jhbenevides02-dev/CPS-FINAL-PROJECT/BUILD/FINAL/AESTHETIC DESIGN/catrina.png

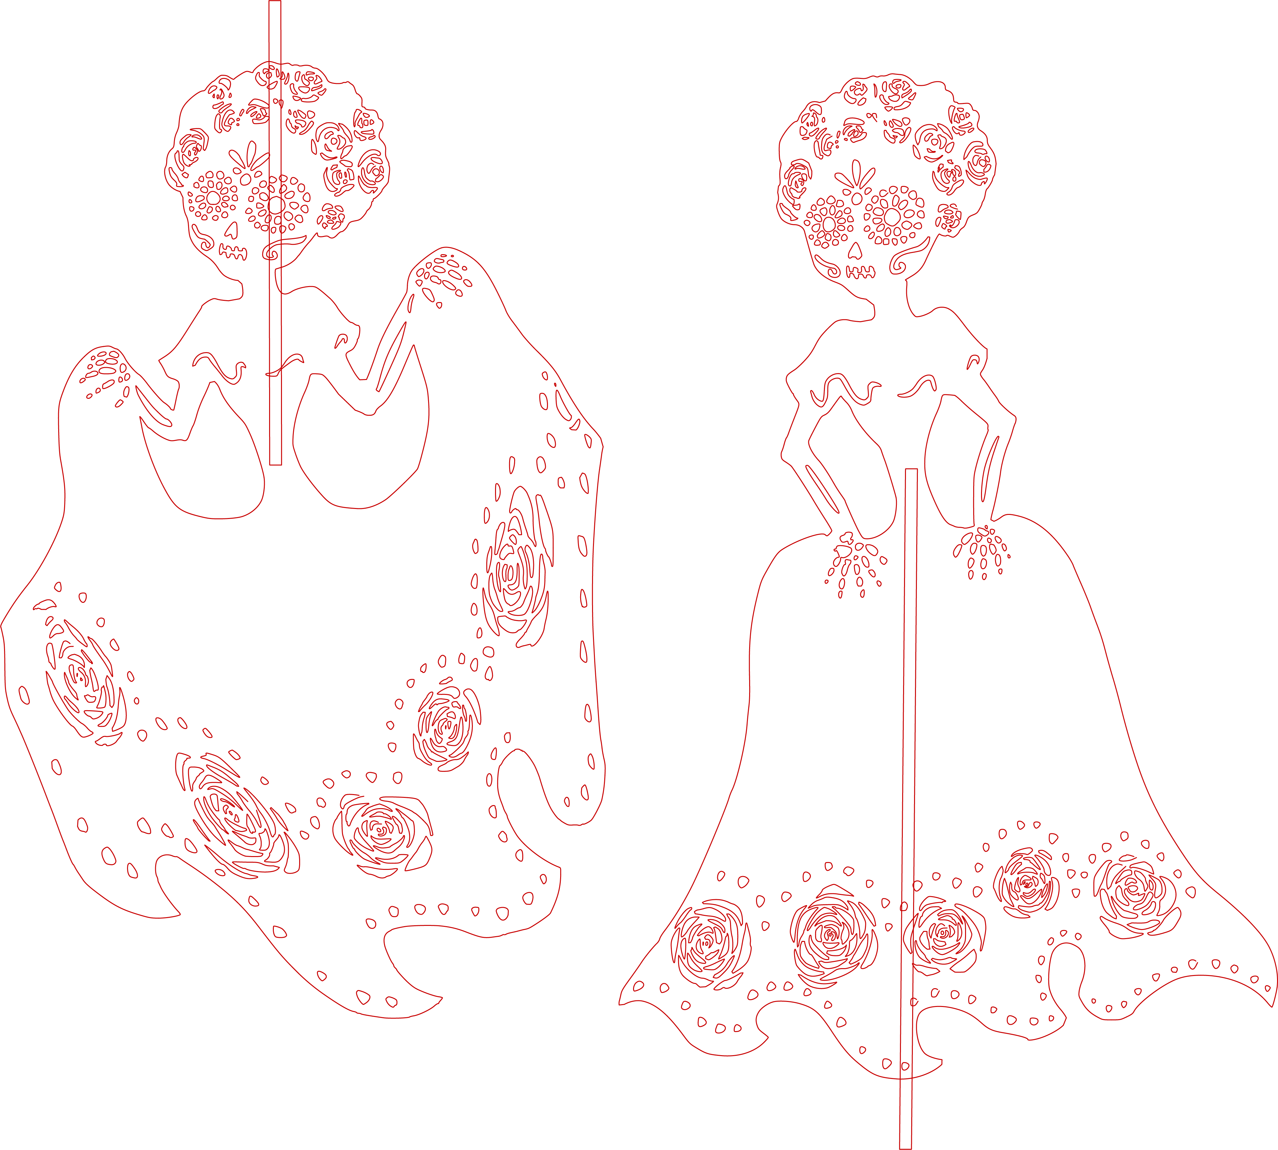
BUILD/FINAL/AESTHETIC DESIGN/catrina.png
