jhbenevides02-dev/CPS-FINAL-PROJECT/BUILD/FINAL/AESTHETIC DESIGN/mariachi.png

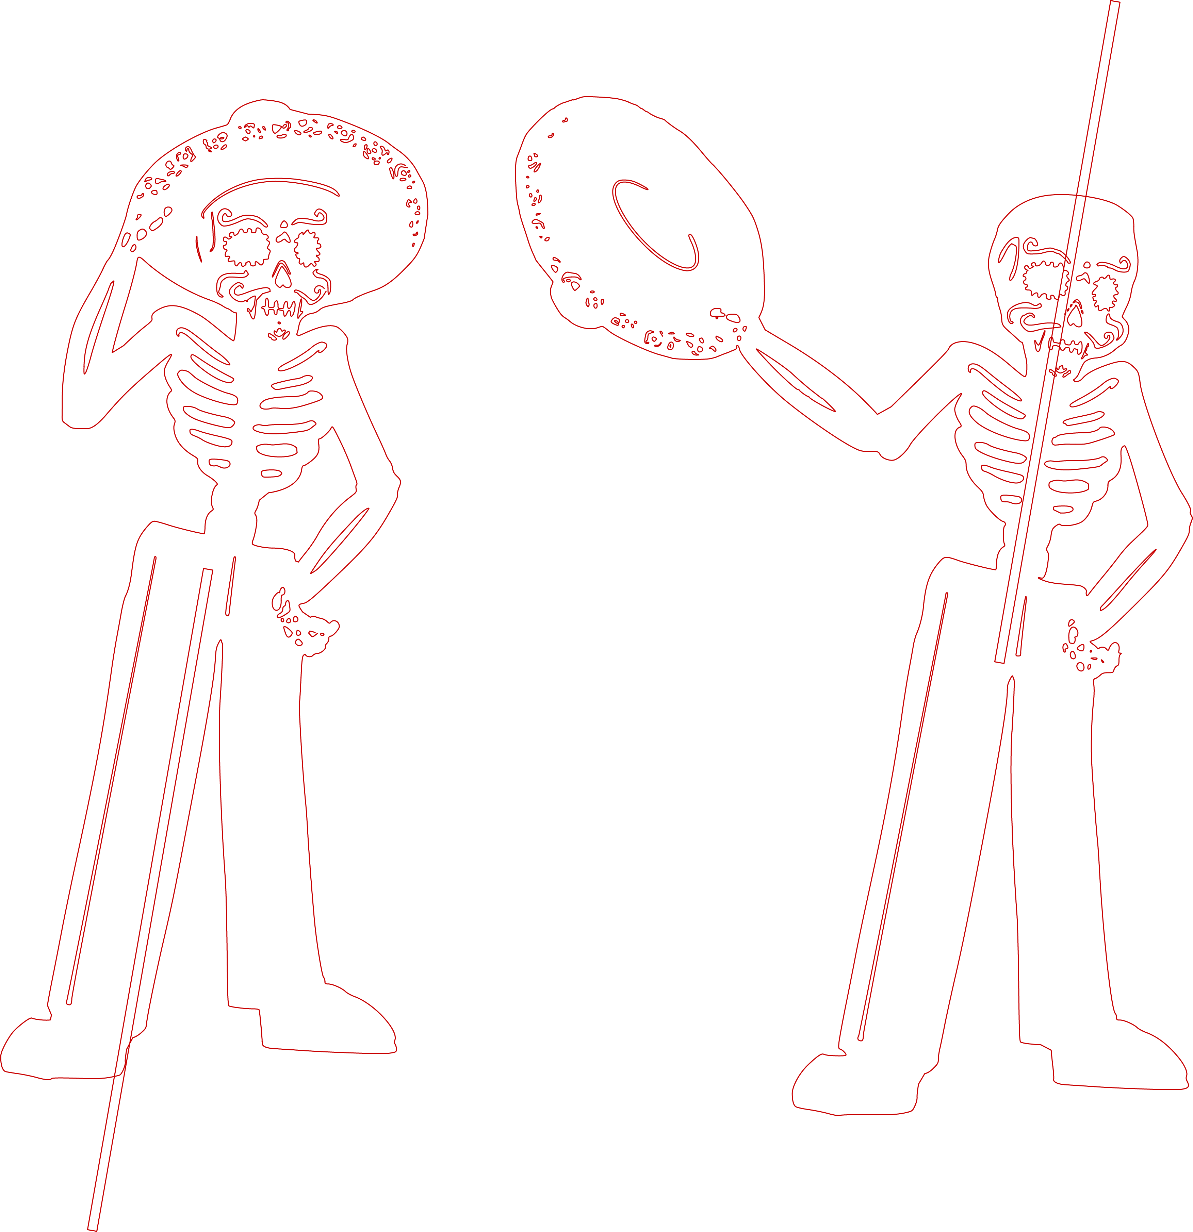
BUILD/FINAL/AESTHETIC DESIGN/mariachi.png
