jhbenevides02-dev/CPS-FINAL-PROJECT/Code/Python/annotated_hand_output.jpg

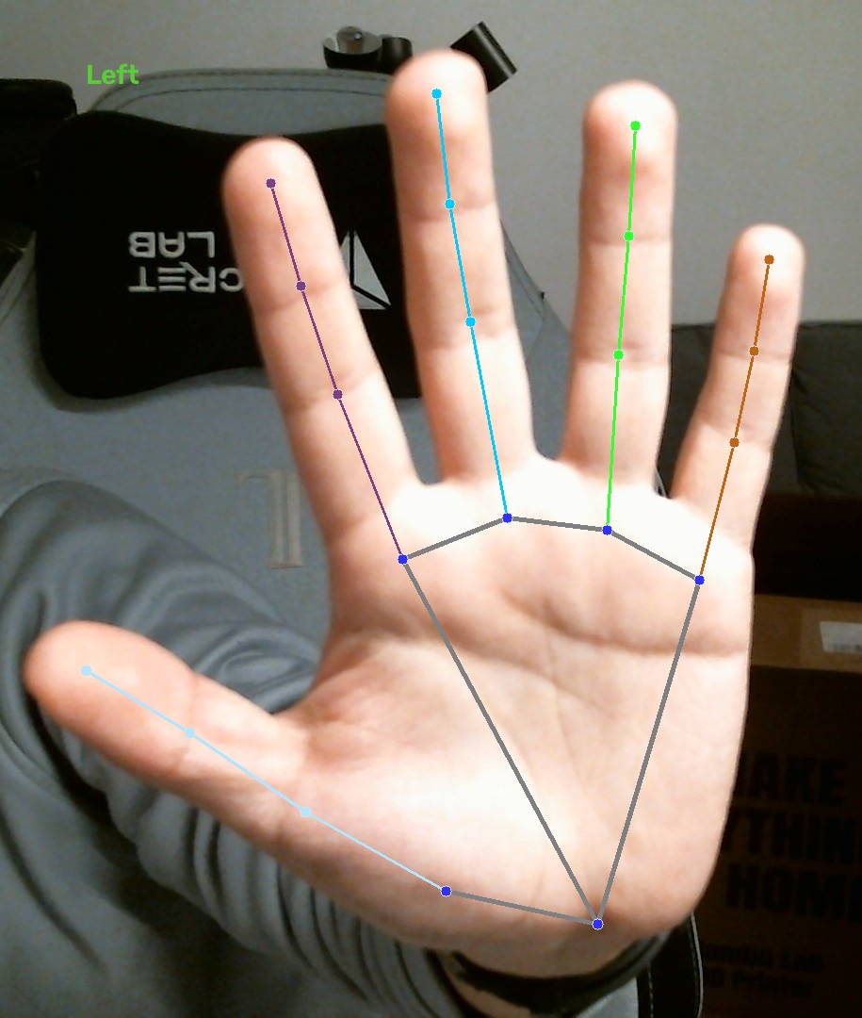
Code/Python/annotated_hand_output.jpg
