jhbenevides02-dev/CPS-FINAL-PROJECT/Code/Python/dataset/action/action_5.jpg

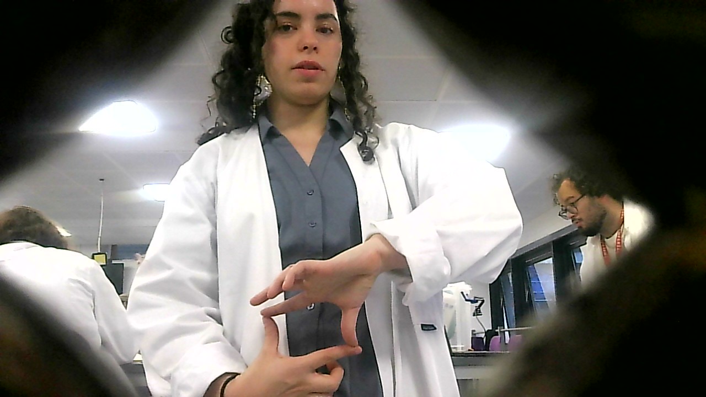
Code/Python/dataset/action/action_5.jpg
