jhbenevides02-dev/CPS-FINAL-PROJECT/Code/Python/dataset/action/action_11.jpg

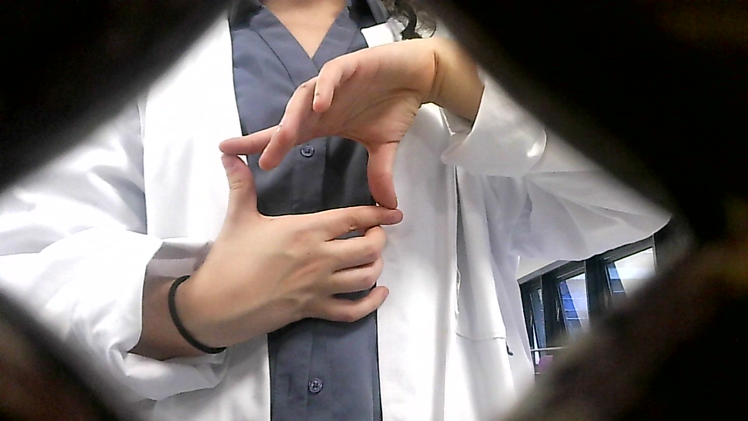
Code/Python/dataset/action/action_11.jpg
