jhbenevides02-dev/CPS-FINAL-PROJECT/Code/Python/dataset/action/action_20.jpg

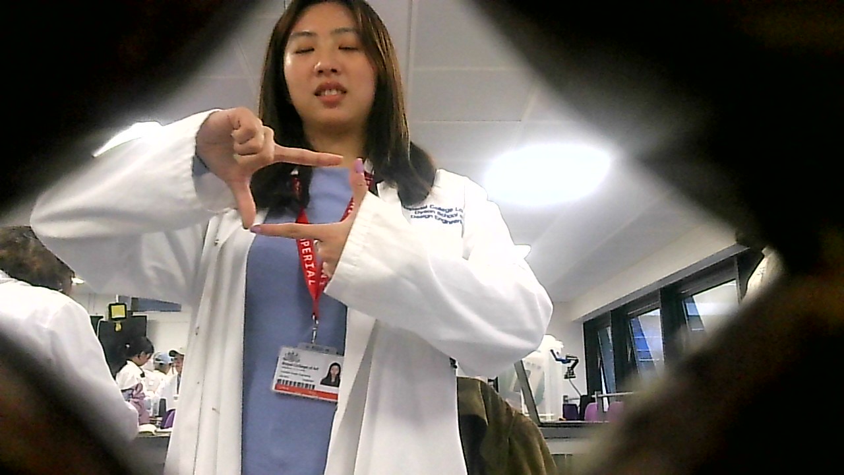
Code/Python/dataset/action/action_20.jpg
