jhbenevides02-dev/CPS-FINAL-PROJECT/Code/Python/dataset/heart/heart_1.jpg

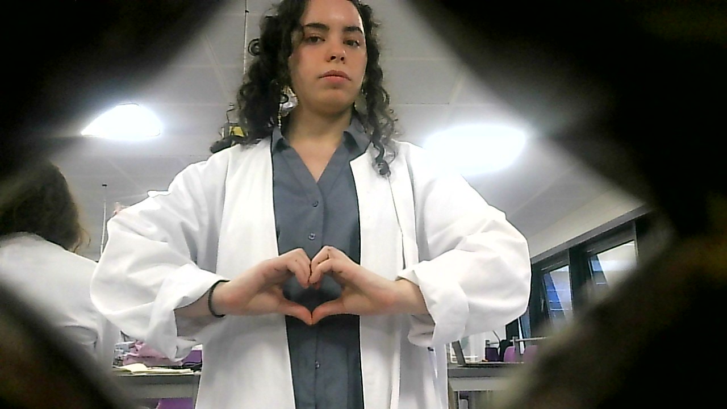
Code/Python/dataset/heart/heart_1.jpg
