jhbenevides02-dev/CPS-FINAL-PROJECT/Code/Python/dataset/heart/heart_5.jpg

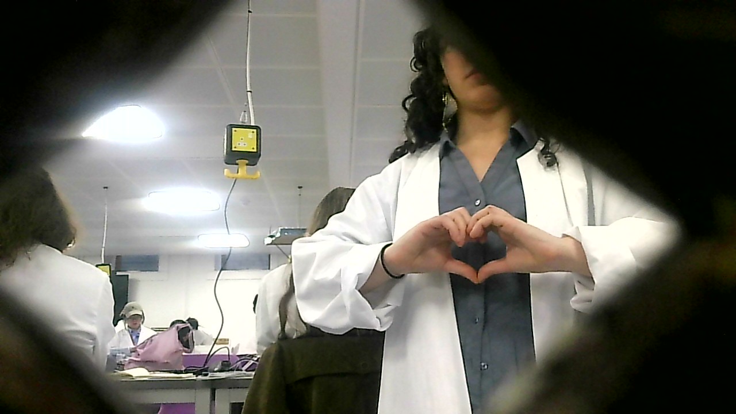
Code/Python/dataset/heart/heart_5.jpg
