jhbenevides02-dev/CPS-FINAL-PROJECT/Code/Python/dataset/heart/heart_13.jpg

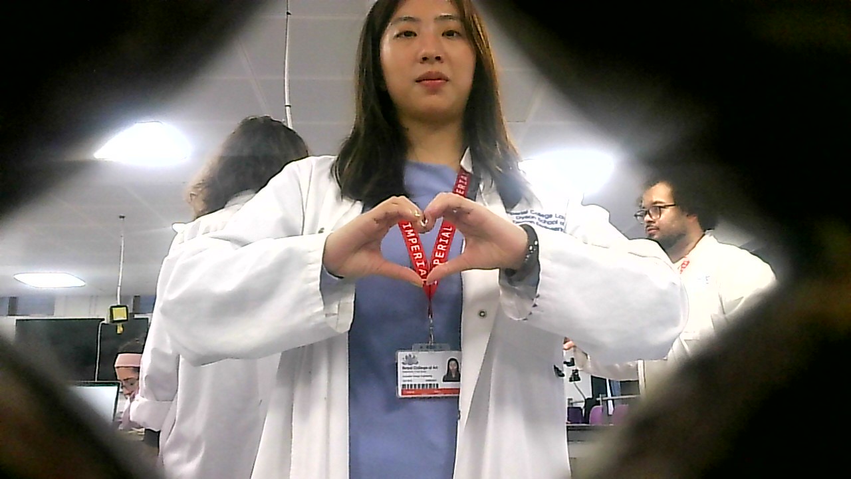
Code/Python/dataset/heart/heart_13.jpg
