jhbenevides02-dev/CPS-FINAL-PROJECT/Code/Python/dataset/none/none_7.jpg

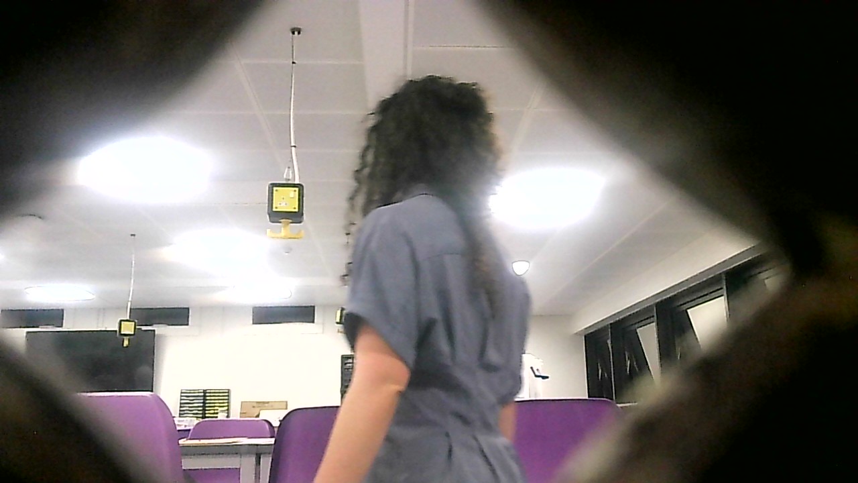
Code/Python/dataset/none/none_7.jpg
