jhbenevides02-dev/CPS-FINAL-PROJECT/Code/Python/dataset/none/none_8.jpg

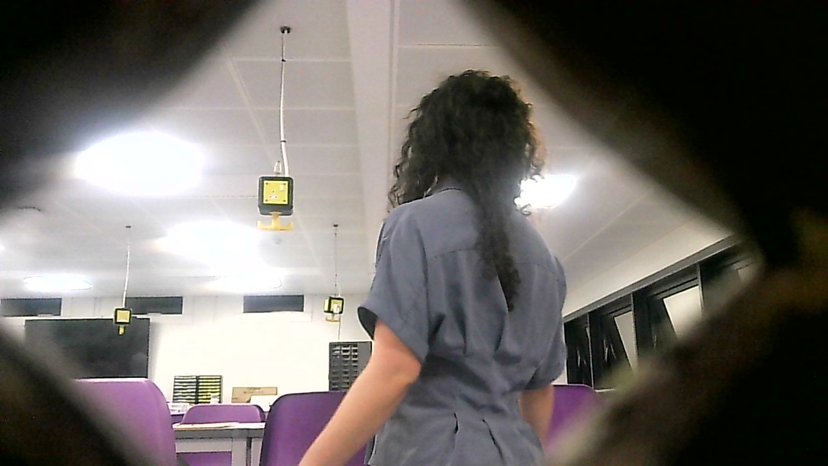
Code/Python/dataset/none/none_8.jpg
