jhbenevides02-dev/CPS-FINAL-PROJECT/Code/Python/dataset/none/none_11.jpg

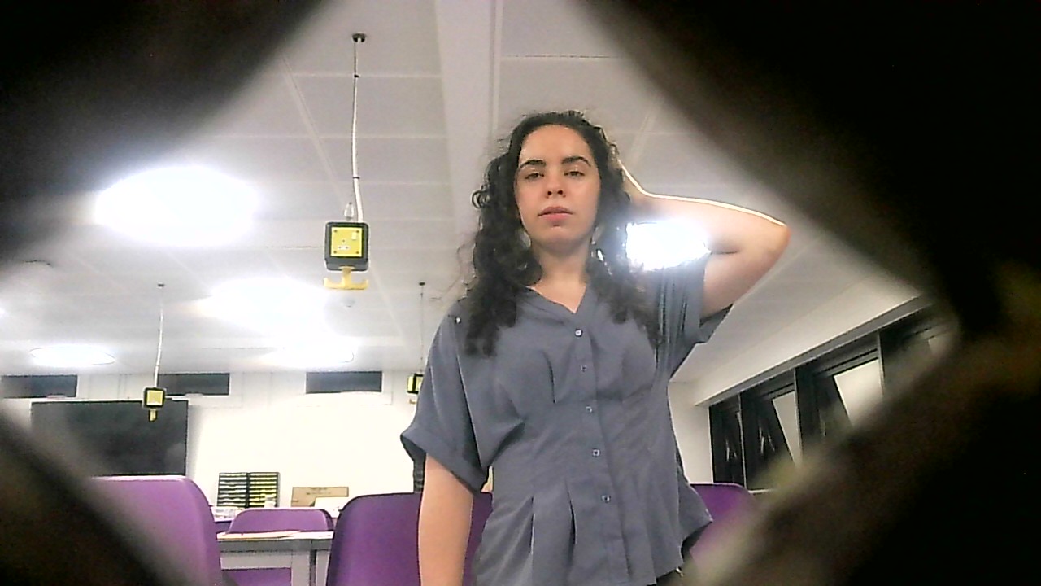
Code/Python/dataset/none/none_11.jpg
