jhbenevides02-dev/CPS-FINAL-PROJECT/Code/Python/dataset/none/none_12.jpg

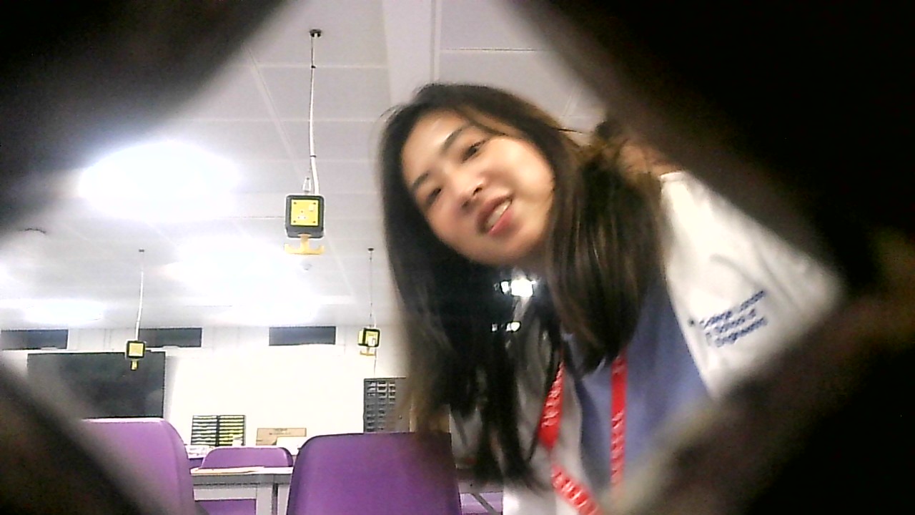
Code/Python/dataset/none/none_12.jpg
