jhbenevides02-dev/CPS-FINAL-PROJECT/Code/Python/dataset/none/none_17.jpg

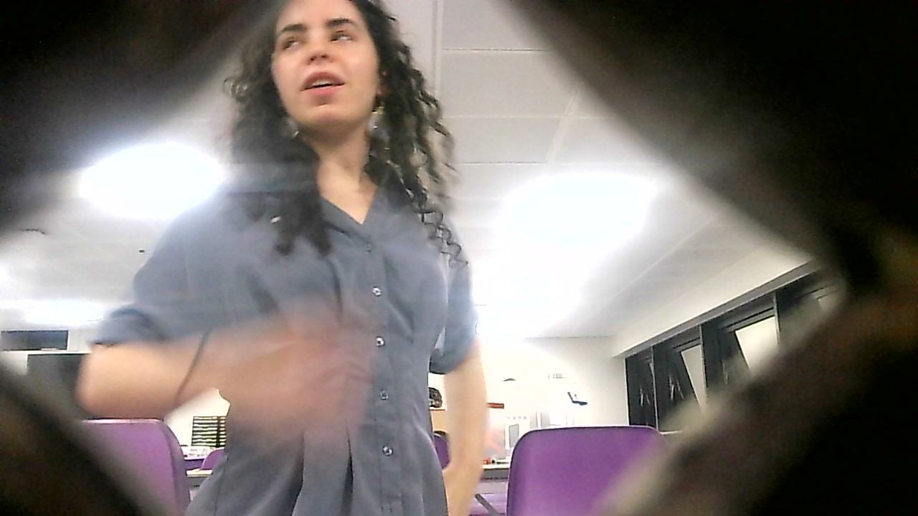
Code/Python/dataset/none/none_17.jpg
