jhbenevides02-dev/CPS-FINAL-PROJECT/Code/Python/dataset/none/none_20.jpg

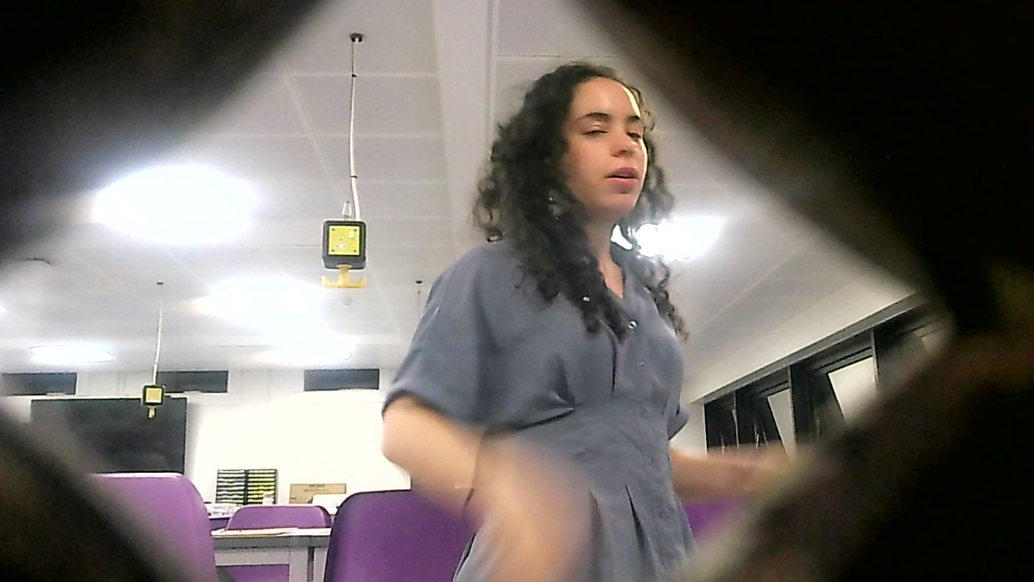
Code/Python/dataset/none/none_20.jpg
