jhbenevides02-dev/CPS-FINAL-PROJECT/Code/WekinatorOnlyPipeline.png

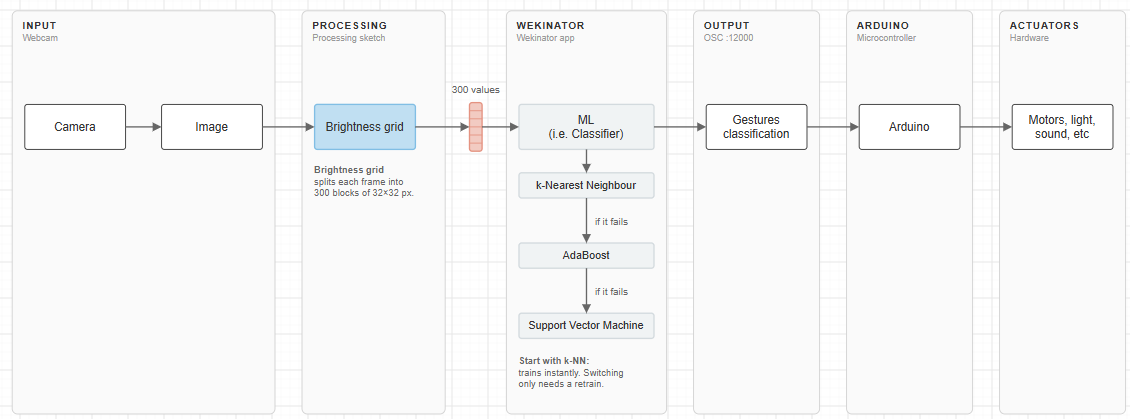
Code/WekinatorOnlyPipeline.png
