jhbenevides02-dev/CPS-FINAL-PROJECT/BUILD/FINAL/AESTHETIC DESIGN/mariachi.dxf

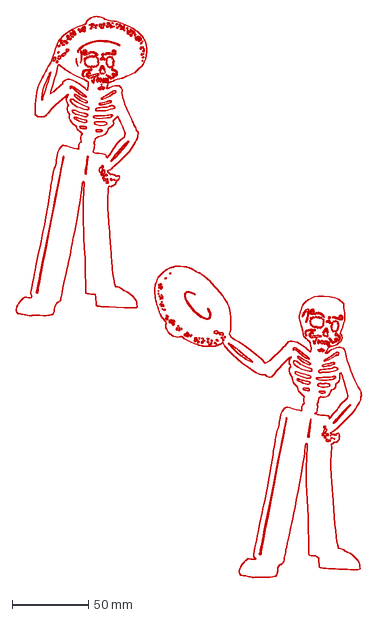
[picture p30: CAD file, 2026-11-13]
BUILD/FINAL/AESTHETIC DESIGN/mariachi.dxf
227.0 x 368.9 mm
