jhbenevides02-dev/CPS-FINAL-PROJECT/BUILD/FINAL/AESTHETIC DESIGN/catrina.dxf

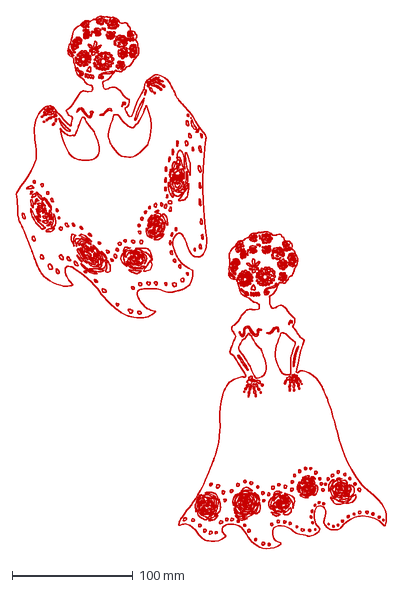
[picture p31: CAD file, 2026-11-13]
BUILD/FINAL/AESTHETIC DESIGN/catrina.dxf
306.9 x 441.2 mm
