jhbenevides02-dev/CPS-FINAL-PROJECT/Code/Simple Pipeline/connection_test/dataset/action/action_28.jpg

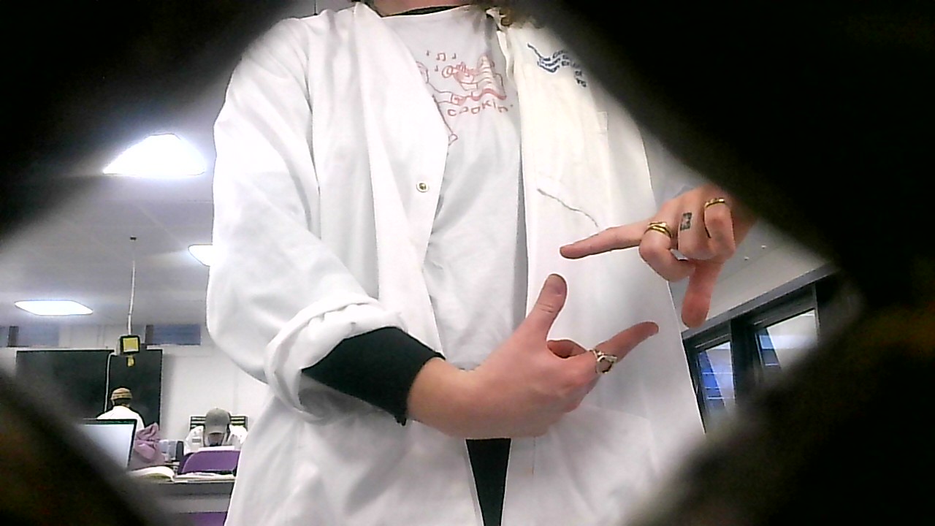
Code/Simple Pipeline/connection_test/dataset/action/action_28.jpg
