jhbenevides02-dev/CPS-FINAL-PROJECT/Code/Simple Pipeline/connection_test/dataset/heart/heart_18.jpg

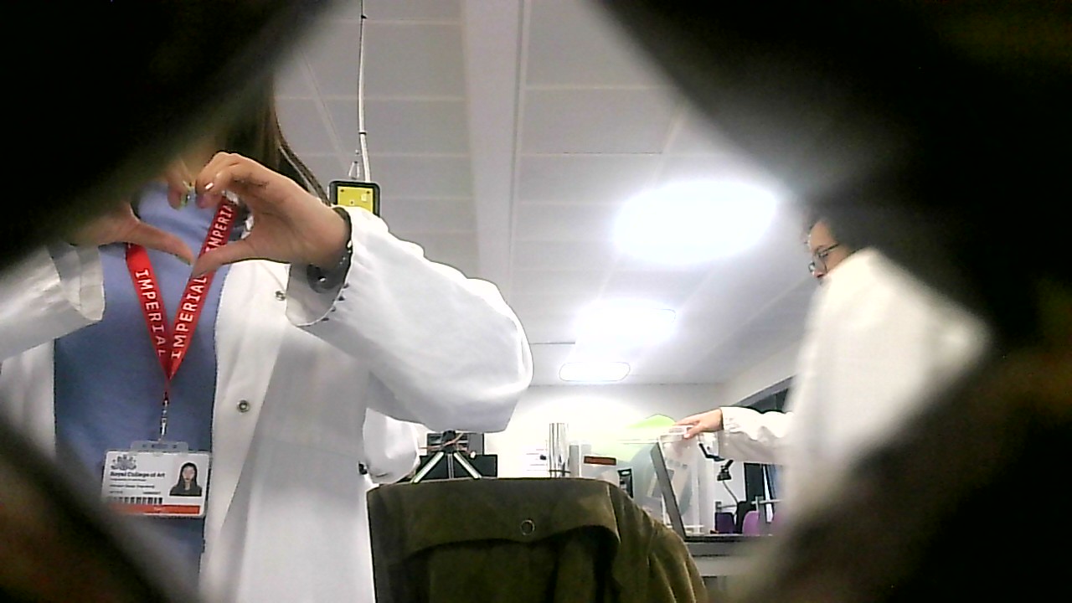
Code/Simple Pipeline/connection_test/dataset/heart/heart_18.jpg
