jhbenevides02-dev/CPS-FINAL-PROJECT/Code/Simple Pipeline/connection_test/dataset/heart/heart_21.jpg

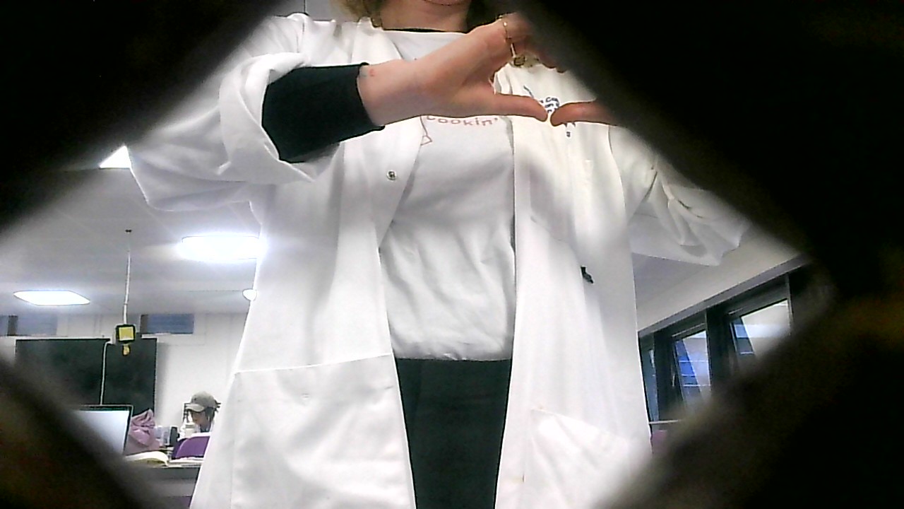
Code/Simple Pipeline/connection_test/dataset/heart/heart_21.jpg
