jhbenevides02-dev/CPS-FINAL-PROJECT/Code/Simple Pipeline/connection_test/dataset/none/none_25.jpg

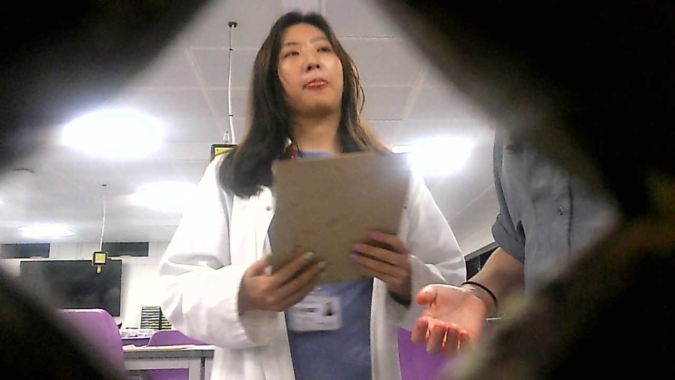
Code/Simple Pipeline/connection_test/dataset/none/none_25.jpg
