jhbenevides02-dev/CPS-FINAL-PROJECT/Code/Simple Pipeline/connection_test/dataset/none/none_29.jpg

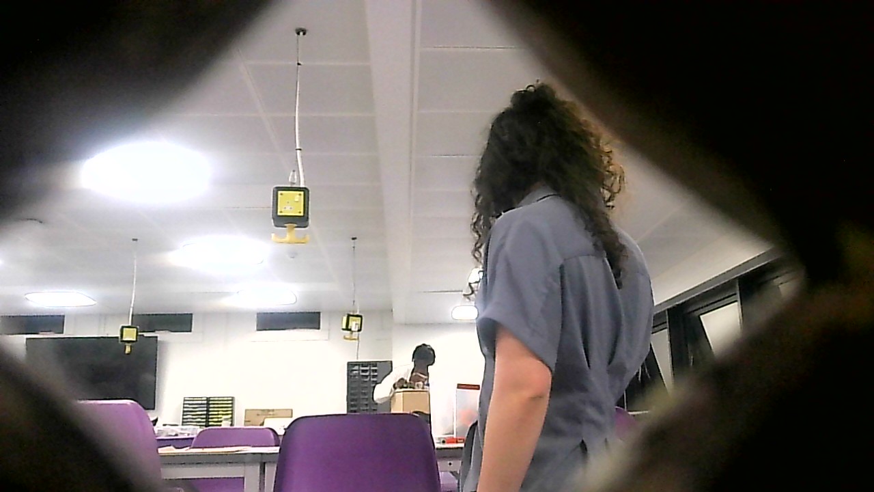
Code/Simple Pipeline/connection_test/dataset/none/none_29.jpg
