jhbenevides02-dev/CPS-FINAL-PROJECT/Code/Simple Pipeline/connection_test/Gesture/Gesture/action_17.jpg

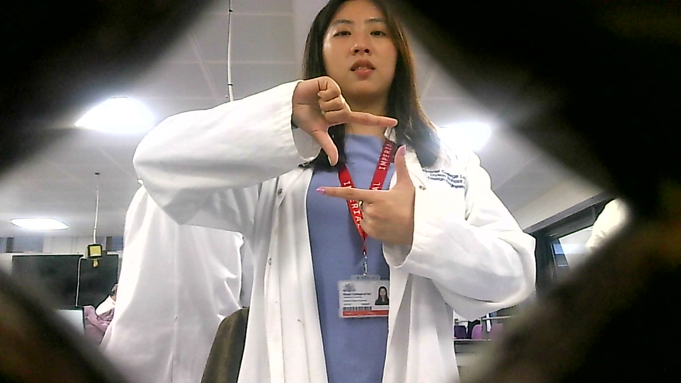
Code/Simple Pipeline/connection_test/Gesture/Gesture/action_17.jpg
