jhbenevides02-dev/CPS-FINAL-PROJECT/Code/Simple Pipeline/connection_test/Gesture/Gesture/action_22.jpg

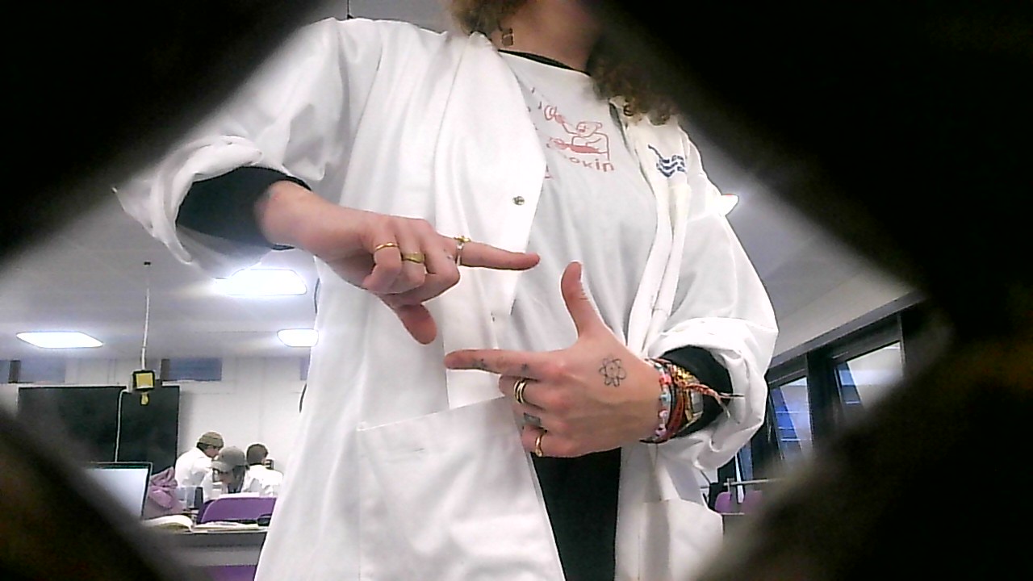
Code/Simple Pipeline/connection_test/Gesture/Gesture/action_22.jpg
