jhbenevides02-dev/CPS-FINAL-PROJECT/Code/Simple Pipeline/connection_test/Gesture/Gesture/action_25.jpg

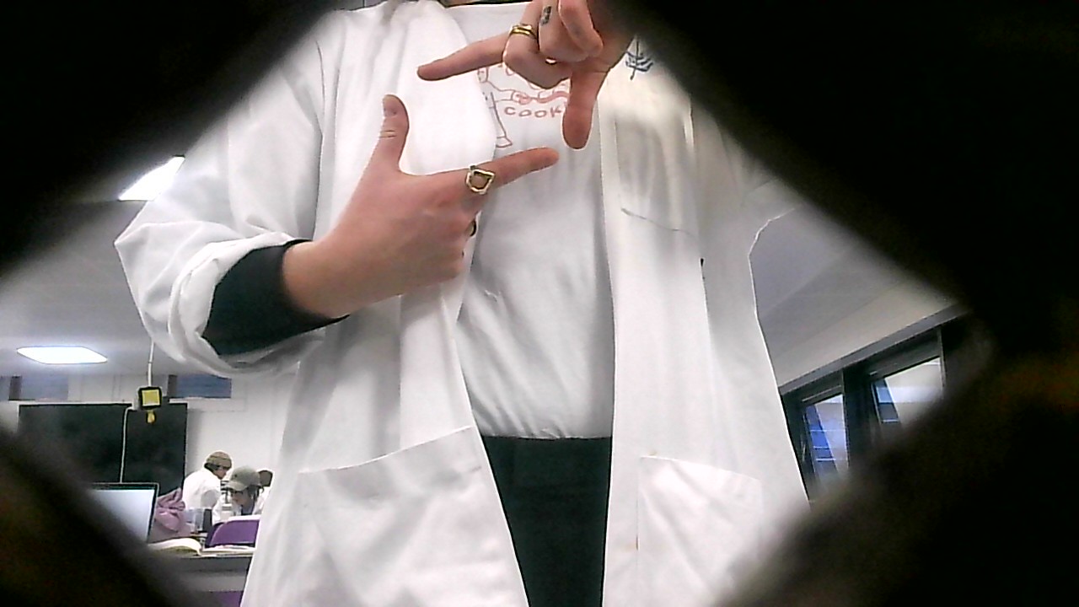
Code/Simple Pipeline/connection_test/Gesture/Gesture/action_25.jpg
