jhbenevides02-dev/CPS-FINAL-PROJECT/Code/Simple Pipeline/connection_test/Gesture/Gesture/heart_12.jpg

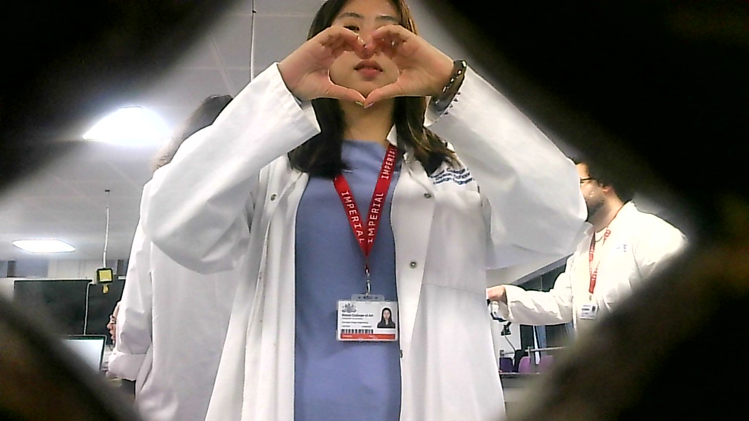
Code/Simple Pipeline/connection_test/Gesture/Gesture/heart_12.jpg
