jhbenevides02-dev/CPS-FINAL-PROJECT/Code/Simple Pipeline/connection_test/Gesture/Gesture/heart_23.jpg

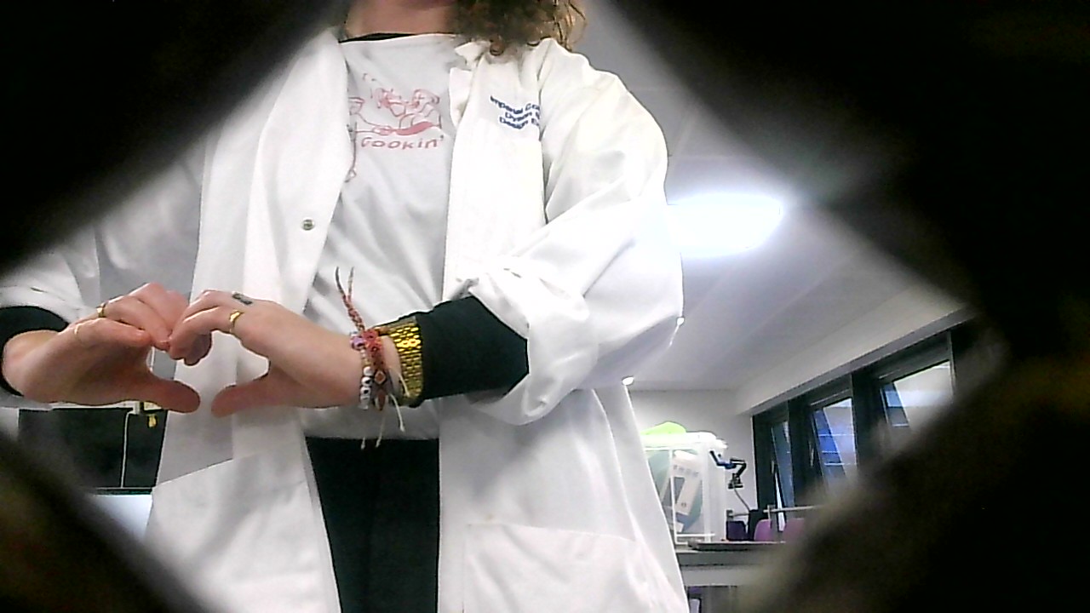
Code/Simple Pipeline/connection_test/Gesture/Gesture/heart_23.jpg
