jhbenevides02-dev/CPS-FINAL-PROJECT/Code/Simple Pipeline/connection_test/no_hand.jpg

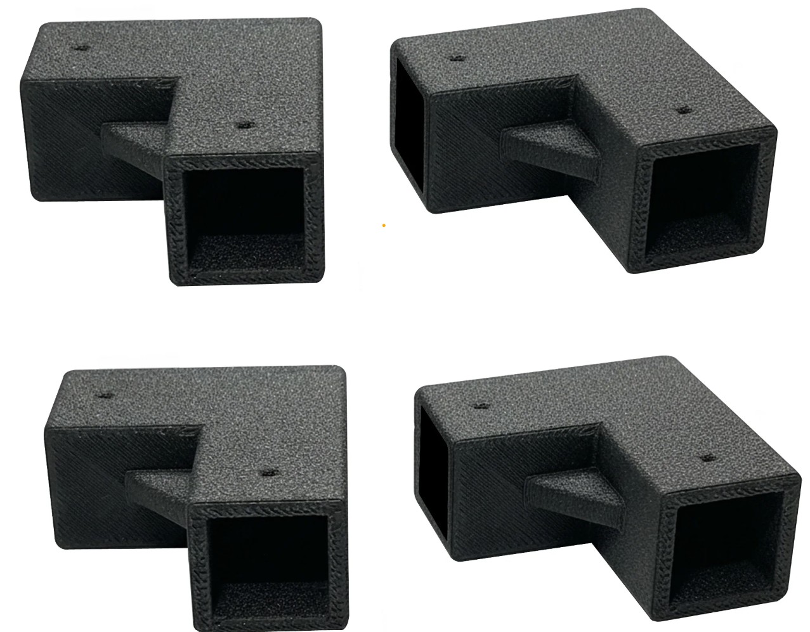
Code/Simple Pipeline/connection_test/no_hand.jpg
