jhbenevides02-dev/CPS-FINAL-PROJECT/Code/Arduino/PuppetScene/PuppetScene.ino

// PuppetScene

// C.G/ECU/2026
// One scene, two actors, each on its own stepper rail. Follows the state machine diagram:
// IDLE -> (HOMING first time) -> Showing: MOVE_12 -> MOVE_21 -> HOLD -> (DANCE) -> ... -> EXIT -> IDLE
//
// Board: Arduino Nano. Library: AccelStepper.
// Serial Monitor at 115200 baud, commands:
//   s = startEvent (both actors)
//   h = heartGesture (both actors)
//
// Each actor is made of 4 pieces that always travel together:
//   xxxSetup   -> fixed values (name, rail limits, speed, home pin)
//   xxxState   -> values that change while running (state, count, flags)
//   xxxStepper -> the motor object
//   xxxServo   -> the servo motor

#include <AccelStepper.h>
#include <Servo.h>

// ---------------------------------------------------------------- Timings (ms)
const unsigned long T_IDLE_WAIT = 1000;   // wait after startEvent before showing
const unsigned long HOLD_MS     = 2000;   // max wait in HOLD (tHold)
const unsigned long RST_HOLD_MS = 5000;   // wait to restart the bucle
const unsigned long SERVO_MOVE_MS = 600;  // time to let the servo finish rotating

// ---------------------------------------------------------------- Motion
const long  DANCE_STEPS   = 1000;   // dance wiggle amplitude
const long  DANCE_SPACE   = 1000; 
const int   DANCE_REPEATS = 2;      // number of wiggles
const float HOMING_SPEED  = 200;    // steps/s while homing
const long  HOMING_MARGIN = 1000;   // extra steps beyond the rail before homing gives up
const int SERVO_REST = 0;           // servo home position


// ----------------------------------------------------------------- Linghting

const uint8_t reflectorPin = 14; // main reflector pin

// ---------------------------------------------------------------- State machine states
enum State : uint8_t { IDLE, HOMING, MOVE_12, MOVE_21, HOLD, DANCE, EXIT };
const char* const STATE_NAMES[] = {"IDLE", "HOMING", "MOVE_12", "MOVE_21", "HOLD", "DANCE", "EXIT"};

// ---------------------------------------------------------------- Actor setup (fixed values)
struct ActorSetup {
  const char* name;
  long minSteps;     // pos 1 (virtual encoder, steps from the home switch)
  long maxSteps;     // pos 2 (steps from the home switch)
  int  direction;    // +1: scene is in the positive direction from home, -1: negative
  float speed;       // steps/s
  float accel;       // steps/s^2
  uint8_t homePin;   // home switch to GND, active LOW (INPUT_PULLUP)
  uint8_t servoPin;
  int servoA;        // servo angle for the "out" move
  int servoB;       // servo angle for the "in" move
};

const ActorSetup CATRINA_SETUP = { // dir +1 starts on the lefit, dir -1 starts from the right
  // name,     min, max,  dir, speed, accel, homePin, servoPin, servoA, servoB
  "catrina",   0,   7293, +1,  350,   200,   3, 15, 90, 0 // max step estimated for GT2 pulley and 143mm travel distance
};

const ActorSetup MARIACHI_SETUP = {
  // name,     min, max,  dir, speed, accel, homePin, servoPin,  servoA, servoB
  "mariachi",    0,   6987, +1,  350,   200,   2, 16, 110, 0 // max step estimated for GT2 pulley and 137mm travel distance
};

// ---------------------------------------------------------------- Actor state (changes while running)
struct ActorState {
  State state = IDLE;
  bool enabled = true;
  bool firstTime = true;
  bool startEvent = false;
  bool heartGesture = false; // flag that detect the moment the hear signal has been detected by wekinator
  bool heartCast = false; // flag that detect is the heart signal has been triggered
  bool idleWaiting = false;
  int  count = 0;
  int  danceIdx = 0;
  unsigned long stateStartMs = 0;
  bool danceOut = true; // next dance move goes toward home
  bool atStage = false; // if the moving is in the middle
  bool servoWaiting = false;          // true while the servo is rotating (stepper off)
  unsigned long servoStartMs = 0;     // time when the servo phase started
};

ActorState catrinaState;
ActorState mariachiState;

// ---------------------------------------------------------------- Steppers
// Pin order is IN1, IN3, IN2, IN4 (required for the 28BYJ-48)
//                                      mode,                 IN1, IN3, IN2, IN4
AccelStepper catrinaStepper (AccelStepper::FULL4WIRE,  8,  10,  9,   11);   // driver pins 8, 9, 10, 11
AccelStepper mariachiStepper(AccelStepper::FULL4WIRE,  4,  6,   5,   7);    // driver pins 4, 5, 6, 7

// ---------------------------------------------------------------- Servo
Servo catrinaServo;
Servo mariachiServo;

// ---------------------------------------------------------------- Helpers
long pos1(const ActorSetup &setup) { return setup.direction * setup.minSteps; } // setup refers to the struct ActorSetup
long pos2(const ActorSetup &setup) { return setup.direction * setup.maxSteps; }
long danceStage(const ActorSetup &setup) { return pos2(setup) - setup.direction * DANCE_SPACE; }
bool homeSwitchPressed(const ActorSetup &setup) { return digitalRead(setup.homePin) == LOW; }

bool anyHoming() {
  return (catrinaState.enabled && catrinaState.state == HOMING) ||
         (mariachiState.enabled && mariachiState.state == HOMING);
}

bool actorReady(const ActorState &actor) { //An actor is ready when its state is IDLE and it has finished its first homing.
  return actor.state == IDLE && !actor.firstTime;
}

bool sceneReady() {
  return (!catrinaState.enabled  || actorReady(catrinaState)) &&
         (!mariachiState.enabled || actorReady(mariachiState));
}

bool bothAtStage() {
  return catrinaState.atStage && mariachiState.atStage;
}
// Function to update the state of an actor
void setState(const ActorSetup &setup, ActorState &actor, State newState) {
  actor.state = newState;
  actor.stateStartMs = millis();
  Serial.print(setup.name);
  Serial.print(" -> ");
  Serial.println(STATE_NAMES[newState]);
}



// *********************************************************
// ******************** State machine **********************
// *********************************************************
// Starts the homing: slow speed, move away from the scene until the home switch is pressed. Goes to HOMING.
void startHoming(const ActorSetup &setup, ActorState &actor, AccelStepper &stepper){

  stepper.setMaxSpeed(HOMING_SPEED);// use a slow speed while homing
  stepper.moveTo(-setup.direction * (setup.maxSteps + HOMING_MARGIN)); // Check directions when fully build
  setState(setup, actor, HOMING); // set state to Homing
}

// Starts a show: reset count, heartCast, heartGesture and startEvent, move to pos 2. Goes to MOVE_12.
void startShowing(const ActorSetup &setup, ActorState &actor, AccelStepper &stepper){
  actor.count = 1;
  actor.heartCast = false;
  actor.heartGesture = false;
  actor.startEvent = false;
  actor.idleWaiting = false;
  actor.atStage = false;
  actor.servoWaiting = false;
  stepper.moveTo(pos2(setup)); // move to pos 2
  setState(setup, actor, MOVE_12); // calls next state
  digitalWrite(reflectorPin, LOW);// TUrns On Reflector
}

//**************************************Let it Cook***************************************
// Runs ONE step of the state machine for one actor (called every loop, never blocks, no delay()).
//   IDLE    : first time -> start homing (one actor at a time); startEvent -> wait T_IDLE_WAIT -> startShowing()
//   HOMING  : home switch pressed -> zero position, restore speed, firstTime = false -> IDLE.
//             Rail travelled without finding the switch -> disable the actor and print an error
//   MOVE_12 : arrived at pos 2 -> move back to pos 1 -> MOVE_21
//   MOVE_21 : arrived at pos 1 -> count++ -> HOLD if count <= 2, otherwise EXIT
//   HOLD    : heartGesture and count == 2 -> DANCE; HOLD_MS elapsed -> move to pos 2 -> MOVE_12
//   DANCE   : wiggle DANCE_REPEATS times around pos 1 -> MOVE_21
//   EXIT    : print "done <name>" -> IDLE
void updateActor(const ActorSetup &setup, ActorState &actor, AccelStepper &stepper, Servo &servo){
  
  switch (actor.state) {
  case IDLE:
    if (actor.firstTime){//check if it is the first power up and any other actor is homing
      if (!anyHoming()) startHoming(setup, actor, stepper);
    }
    else if(actor.startEvent){
      if(!actor.idleWaiting){
        actor.idleWaiting = true; // set idle waiting after homing
        actor.stateStartMs = millis();
      }
      else if(millis()-actor.stateStartMs >= T_IDLE_WAIT){
        startShowing(setup, actor, stepper);
      }
    }
    break;
  case HOMING:
    if (homeSwitchPressed(setup)) {
      
      stepper.setCurrentPosition (0);// Set current position as zero home
      stepper.setMaxSpeed(setup.speed); // Set normal max speed
      stepper. moveTo(pos1(setup)); // uses the helper pos1

      actor.firstTime = false; //end homing
      setState(setup, actor, IDLE); // update state to IDLE after homing

    }

    else if (stepper.distanceToGo() == 0){
      
      actor.enabled = false; // disabe actor
      stepper.disableOutputs(); // turn off motor
      Serial.print (setup.name);
      Serial.println(" --> Error, check limit switch");
    }
    // 2. switch pressed? 3. rail finished without the switch?
    break;
  case MOVE_12:

    if (stepper.distanceToGo()==0){ // once it has reached pos 2
      Serial.println("In Pos 2");
      stepper.moveTo(pos1(setup)); // move to pos 1
      
      setState(setup,actor,MOVE_21);
    }
    break;
  case MOVE_21:

    if (stepper.distanceToGo()==0 || homeSwitchPressed(setup)){// once it has reached pos 1 or switch the home
        
        if (homeSwitchPressed(setup)) stepper.setCurrentPosition(0);// re-zero home
        Serial.println ("In Pos 1");
        setState(setup,actor,HOLD); // hold for HOLD_MS for the next action or exit
    }
    break;
  case HOLD:

    // check if a heart geture have been detected and received. Then trigger the DANCE event
    if (actor.heartGesture && actor.count<2 && !actor.heartCast){
      actor.heartCast = true;
      actor.heartGesture = false;
      if (actor.count == 1) actor.count=2; // in case the gesture have been received in the first cycle.
      actor.danceIdx = 0;
      actor.atStage = false;
      stepper.moveTo (danceStage(setup)); // First go to the center of the stage
      setState(setup,actor, DANCE); // set DANCE state
      actor.danceOut = true;
    }
    else if (millis()-actor.stateStartMs >= HOLD_MS && actor.count<2){// keep going with
          actor.count +=1; // now count is 2
          stepper.moveTo(pos2(setup)); // move to pos 2
          setState(setup,actor,MOVE_12);
    }
    else if (actor.count>=2){

      stepper.disableOutputs();
      setState(setup,actor,EXIT);
      digitalWrite(reflectorPin, HIGH); //if (!anyShowing()) the last actor to finish turning off
      // Create anyShowing helper
    }
    break;
  
  case DANCE:

  {
    long stagePos  = danceStage(setup);
    long wigglePos = stagePos - setup.direction * DANCE_STEPS;

    if (actor.servoWaiting) {                          // servo rotating, stepper is off
      if (millis() - actor.servoStartMs >= SERVO_MOVE_MS) {
        actor.servoWaiting = false;
        stepper.enableOutputs();                       // stepper back on

        if (actor.danceIdx >= 2 * DANCE_REPEATS) {     // the last servo phase was the rest
          stepper.moveTo(pos1(setup));
          setState(setup, actor, MOVE_21);
        }
        else {
          if (actor.danceOut) stepper.moveTo(wigglePos);
          else                stepper.moveTo(stagePos);
          actor.danceOut = !actor.danceOut;
          actor.danceIdx++;
        }
      }
    }
    else if (stepper.distanceToGo() == 0) {            // stepper stopped
      actor.atStage = true;

      if (bothAtStage()) {                             // both on stage
        int angle;
        if (actor.danceIdx >= 2 * DANCE_REPEATS) angle = SERVO_REST;
        else if (actor.danceOut)                 angle = setup.servoA;
        else                                     angle = setup.servoB;

        stepper.disableOutputs();                      // stepper off while the servo moves
        servo.write(angle);
        actor.servoStartMs = millis();
        actor.servoWaiting = true;
      }
    }
  }

    break;
  case EXIT:
    if (millis()-actor.stateStartMs >= RST_HOLD_MS){
      stepper.enableOutputs(); // energize motors again
      setState(setup, actor, IDLE);
    }

    break;
  default:        // the other states are written later
    break;
}
}

// ---------------------------------------------------------------- Serial commands
// Prints name, state, stepper position, count and enabled for one actor.
void printStatus(const ActorSetup &setup, ActorState &actor, AccelStepper &stepper);

// Raises startEvent for one actor, only if it is enabled and in IDLE.
void sendStartEvent(ActorState &actor){
  if (actor.enabled && actorReady(actor)) actor.startEvent = true; // set start show event to true.
}

// Raises heartGesture for one actor, only if it is enabled and not in IDLE or HOMING.
void receiveHeartGesture(ActorState &actor){

  if (actor.enabled && actor.state != IDLE && actor.state != HOMING) actor.heartGesture = true;// Set actor state to true

}

// Reads the Serial Monitor: 's' = startEvent, 'h' = heartGesture, 'p' = print status (all actors).
void handleSerial(){
  while (Serial.available()){
    char c = Serial.read();
    if (c == 's'){
      if (sceneReady()) {
        sendStartEvent(catrinaState);
        sendStartEvent(mariachiState);
        Serial.println("Start Show");
      }
      else {
        Serial.println("Not ready, start ignored");
      }
    }
    if (c == 'h'){
      receiveHeartGesture(catrinaState);
      receiveHeartGesture(mariachiState);
      Serial.println("Dance!");
    }
    if (c == 'v'){
      catrinaServo.write(CATRINA_SETUP.servoA);
      mariachiServo.write(MARIACHI_SETUP.servoA);
      Serial.println("Servos -> A");
    }
    if (c == 'r'){
      catrinaServo.write(SERVO_REST);
      mariachiServo.write(SERVO_REST);
      Serial.println("Servos -> REST");
    }
  }
}

// ---------------------------------------------------------------- Actor setup and run
// Configures one actor: home pin as INPUT_PULLUP, stepper max speed and acceleration from its setup.
void setupActor(const ActorSetup &setup, AccelStepper &stepper, Servo &servo){
  
  pinMode(setup.homePin, INPUT_PULLUP); // Setup carriages limit switches
  stepper.setMaxSpeed(setup.speed);     // Setup stepper max speed
  stepper.setAcceleration(setup.accel); // Setup stepper acceleration
  servo.write(SERVO_REST); // set servo home
  servo.attach(setup.servoPin);
}

// Called every loop for one actor: skip if disabled, call stepper.run(), then updateActor().
void runActor(const ActorSetup &setup, ActorState &actor, AccelStepper &stepper, Servo &servo){
  
  if (!actor.enabled) return; // only runs if the actor is enable
  updateActor(setup, actor, stepper, servo); // update actor states (State machine)
  stepper.run(); // calling run as often as possible
}

// ---------------------------------------------------------------- Arduino
void setup() {

  Serial.begin(115200);
  setupActor(CATRINA_SETUP, catrinaStepper, catrinaServo);    // Setup catrina actor
  setupActor(MARIACHI_SETUP, mariachiStepper, mariachiServo);  // Setup mariachi actor
  pinMode(reflectorPin, OUTPUT);
  digitalWrite(reflectorPin, HIGH); // Turns off reflector
  Serial.println("PuppetScene ready. Commands: s = startEvent, h = heartGesture, p = status");

}

void loop() {
  
  handleSerial();
  
  runActor(CATRINA_SETUP, catrinaState, catrinaStepper, catrinaServo);
  runActor(MARIACHI_SETUP, mariachiState, mariachiStepper, mariachiServo);
}

// Si estás leyendo esto, este código fue escrito por un ecuatoriano
