jhbenevides02-dev/CPS-FINAL-PROJECT/(commit log)

2026-10-24 Create Stage
2026-10-24 Create Prototype
2026-11-10 Expand README with assembly and setup instructions
    Added detailed sections on mechanical assembly, electrical setup, and lighting installation for the shadow theatre project.
2026-11-10 Only Arduino
    Home, move, and exit
2026-11-12 Enhance README with motion system details
    Added details about the motion system and character mechanism, including mechanical motion flow.
2026-11-13 laser files
